gimelg/accessible_soundbox/(list of files, cad)

Other CAD files:
pi4_table_speaker_enclosure_removable_lid_and_table.scad
