gimelg/accessible_soundbox/(commit log)

2025-12-15 more economical speaker table
    [pi4_table_speaker_enclosure_removable_lid_and_table.scad]
2025-12-16 pouch for volume knob, speakers move upwards to make space for supporting ribs, additional poll to support table
    [pi4_table_speaker_enclosure_removable_lid_and_table.scad]
2025-12-16 rotate lid and table so that pouch is closer to pi in case short cables
    [pi4_table_speaker_enclosure_removable_lid_and_table.scad]
2025-12-16 rotate pouch 90 degrees so that cables run to the side of table beam
    [pi4_table_speaker_enclosure_removable_lid_and_table.scad]
2025-12-16 tightning dimenssions, speakers flush with top of lid
    [pi4_table_speaker_enclosure_removable_lid_and_table.scad]
2025-12-16 lid attaches wih screws, base and table adjusted accordingly
    [pi4_table_speaker_enclosure_removable_lid_and_table.scad]
2025-12-16 change boat to narrow towards the bottom only length-wise
    [pi4_table_speaker_enclosure_removable_lid_and_table.scad]
2025-12-16 shorten screw holes so they don't go through all the way to the base
    [pi4_table_speaker_enclosure_removable_lid_and_table.scad]
2025-12-20 diemnsions adjustments after printing
    [pi4_resized_to_8_inch_max_soundbox.scad]
2025-12-20 table is supported off center to not block center button wiring
    [pi4_resized_to_8_inch_max_soundbox.scad]
2025-12-20 a bit larger button holes for easier fit
    [pi4_resized_to_8_inch_max_soundbox.scad]
2025-12-20 fix bug in lid rendering
    [pi4_resized_to_8_inch_max_soundbox.scad]
2025-12-21 adding option to stand on side of ports opening
    the reason being that the whole thing weighs very little, which makes
    pushing buttons awkward. when standing upright, buttons are pushed from
    above.
    this required moving the usb-c slit to the adjacent wall, and adding
    additional support for speakers on the table pads.
    also button holes a bit smaller now, they were enlarged too much before
    and protrude from behind the side buttons.
    [pi4_resized_to_8_inch_max_soundbox.scad]
2025-12-23 adjust speaker vertical support when upright
    [pi4_resized_to_8_inch_max_soundbox.scad]
